jankralx/tt04-fm-transmitter/doc/board_photos/bot.jpg

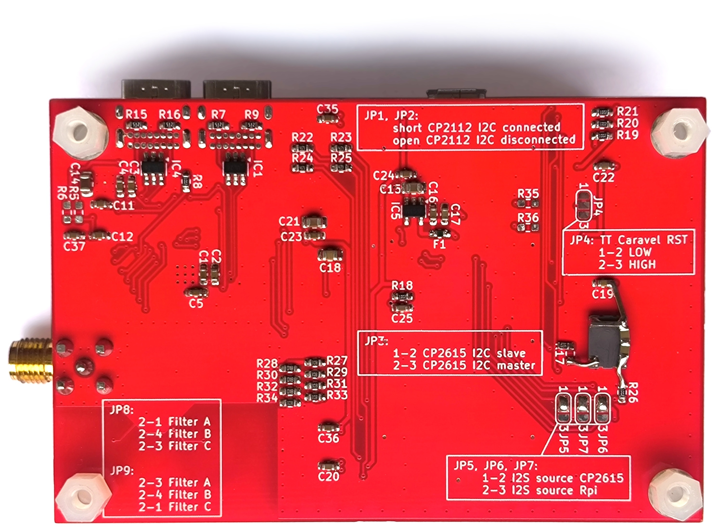
doc/board_photos/bot.jpg
