jankralx/tt04-fm-transmitter/doc/SDR_music.png

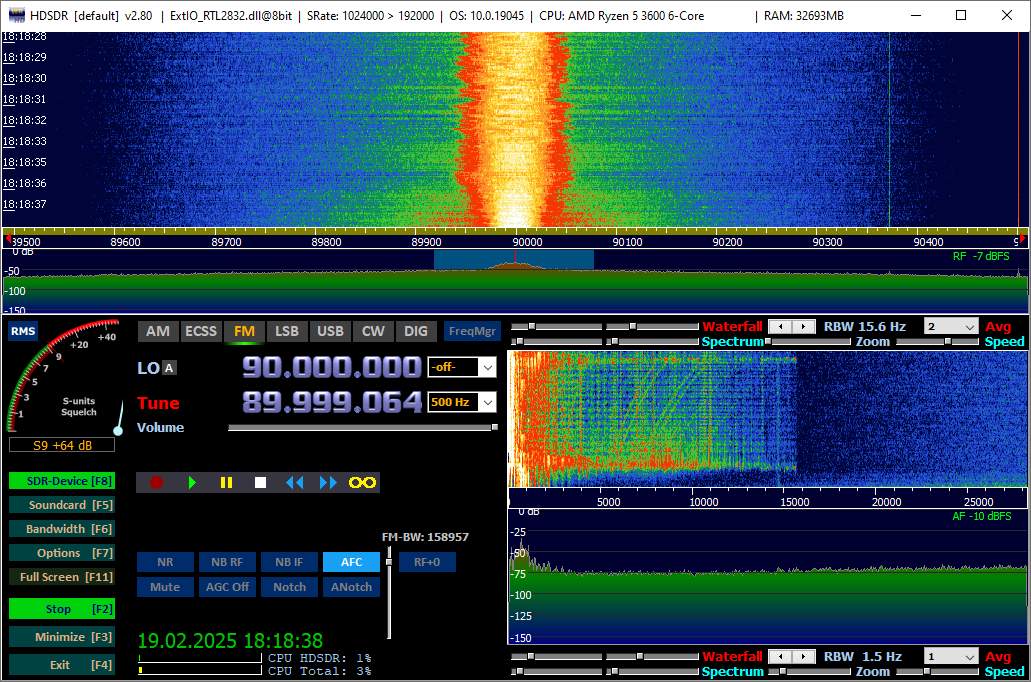
doc/SDR_music.png
