jankralx/tt04-fm-transmitter/doc/PDFs/diagram.pdf

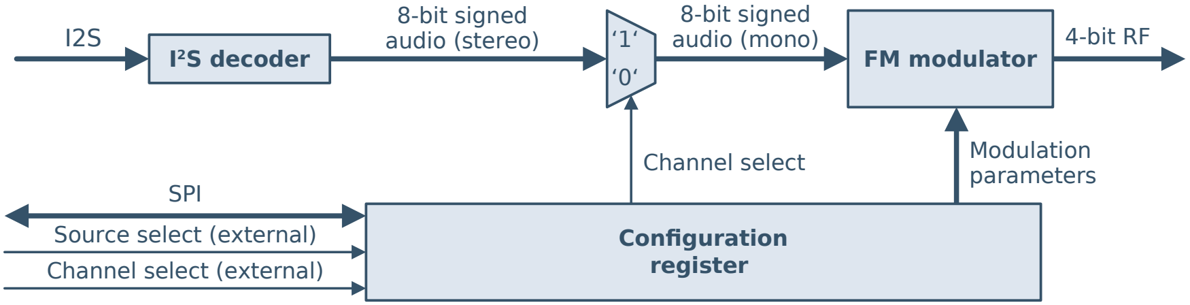
[picture p3: figure]
FM modulator; 4-bit RF; 8-bit signed audio (mono); 8-bit signed audio (stereo); SPI; 2S decoder; Channel select; Modulation; parameters; Configuration register; Source select (external); Channel select (external)
