jankralx/tt04-fm-transmitter/doc/board_photos/top.jpg

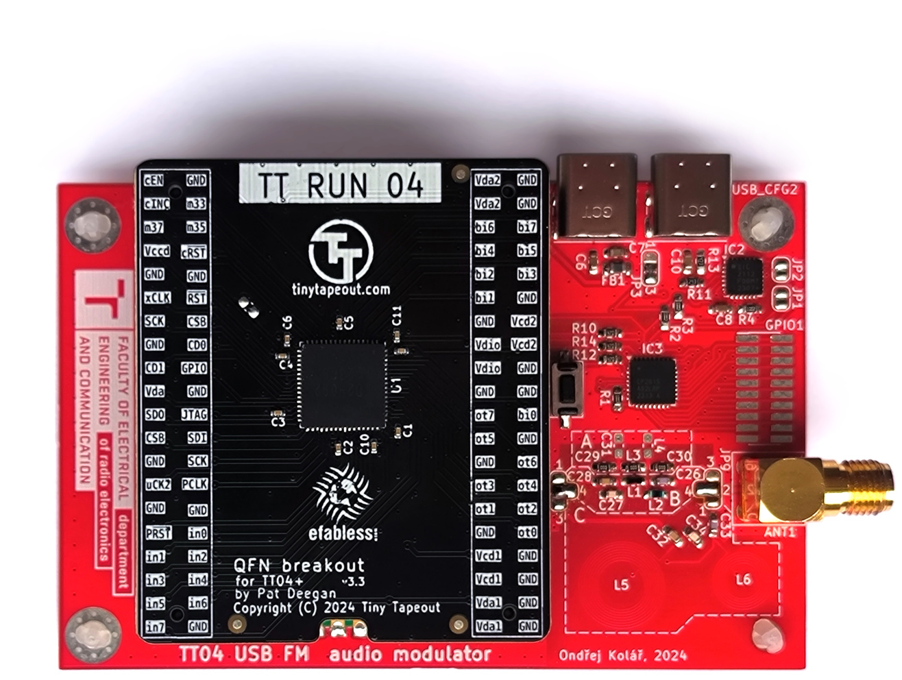
doc/board_photos/top.jpg
