jankralx/tt04-fm-transmitter/doc/figureApproximation.png

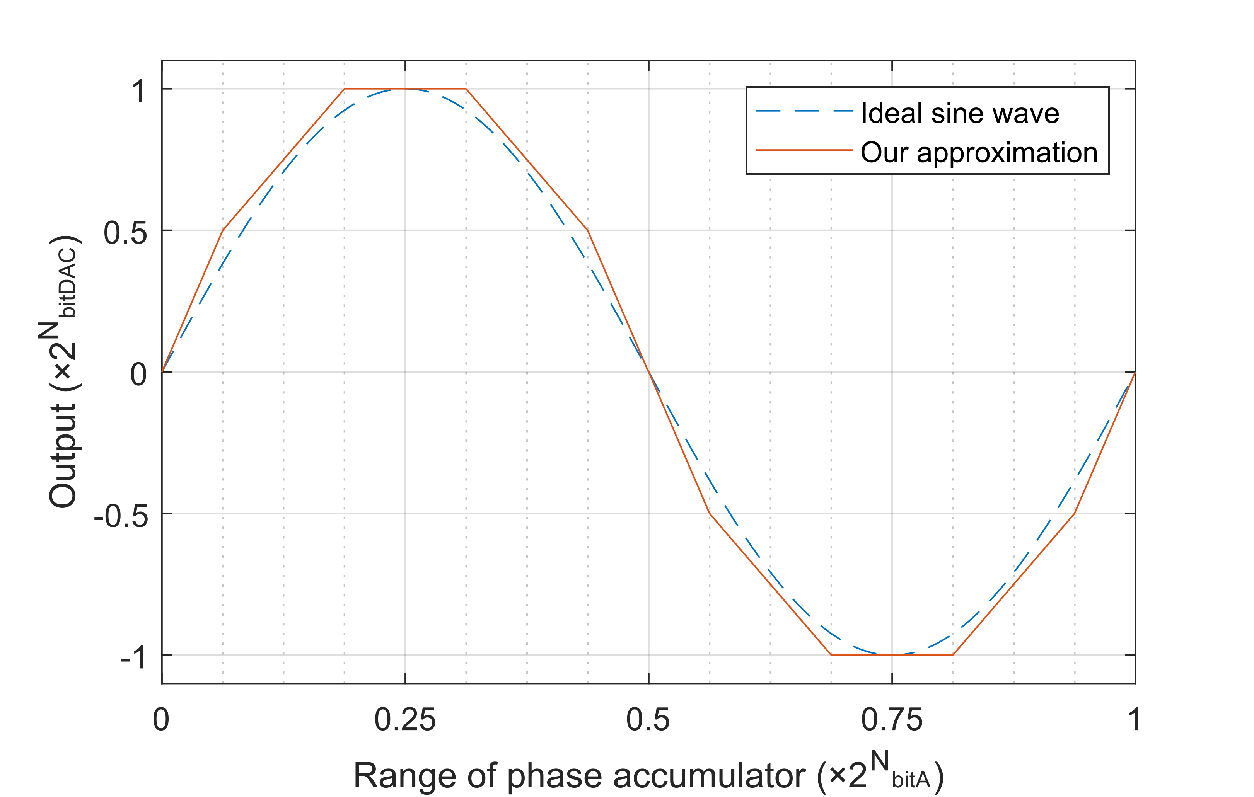
doc/figureApproximation.png
