jankralx/tt04-fm-transmitter/doc/measurements/spectra/10MHzSpan10kNemodul.png

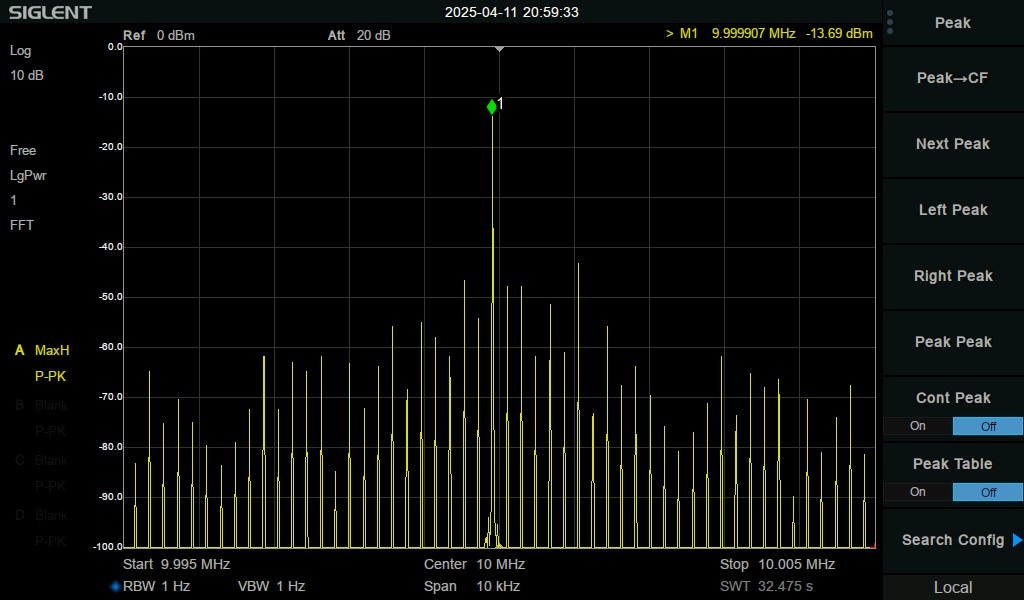
doc/measurements/spectra/10MHzSpan10kNemodul.png
