jankralx/tt04-fm-transmitter/doc/measurements/spectra/10MHzSpan100kNemodul.png

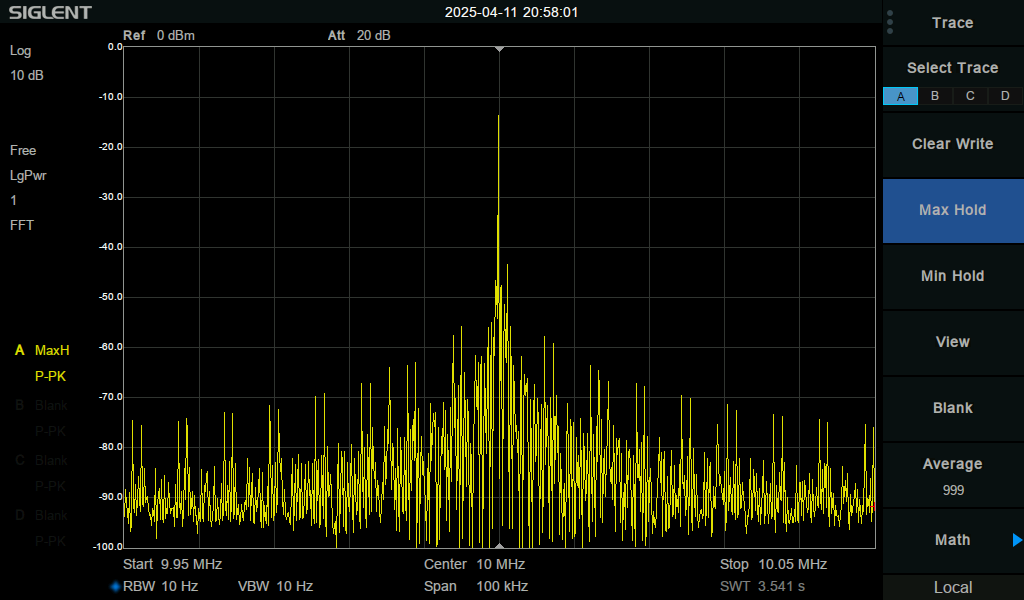
doc/measurements/spectra/10MHzSpan100kNemodul.png
