jankralx/tt04-fm-transmitter/doc/measurements/spectra/10MHzSpan200kModul1kHz.png

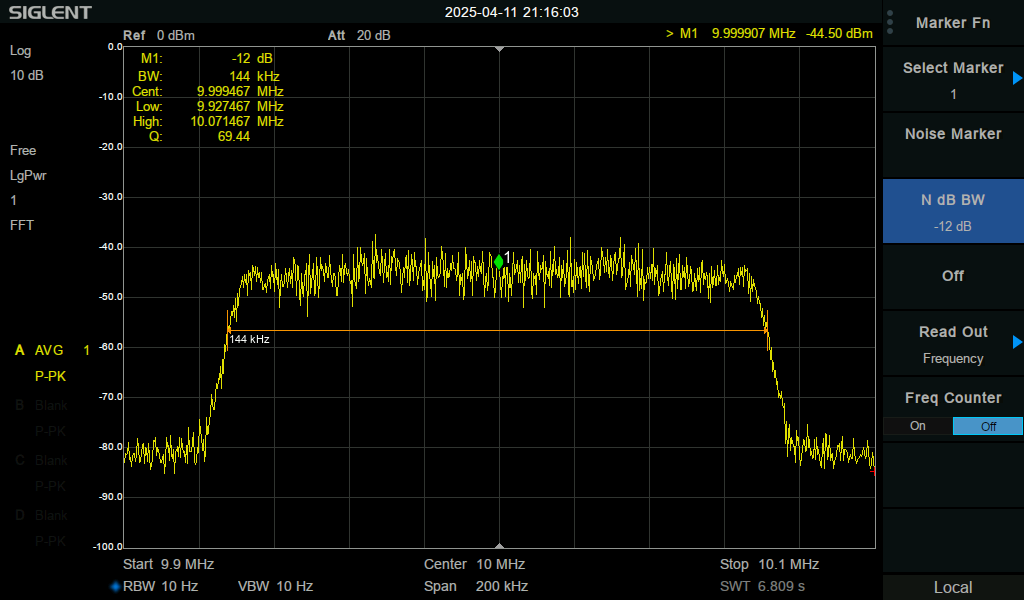
doc/measurements/spectra/10MHzSpan200kModul1kHz.png
