jankralx/tt04-fm-transmitter/doc/measurements/spectra/10MHzSpan200kNemodul.png

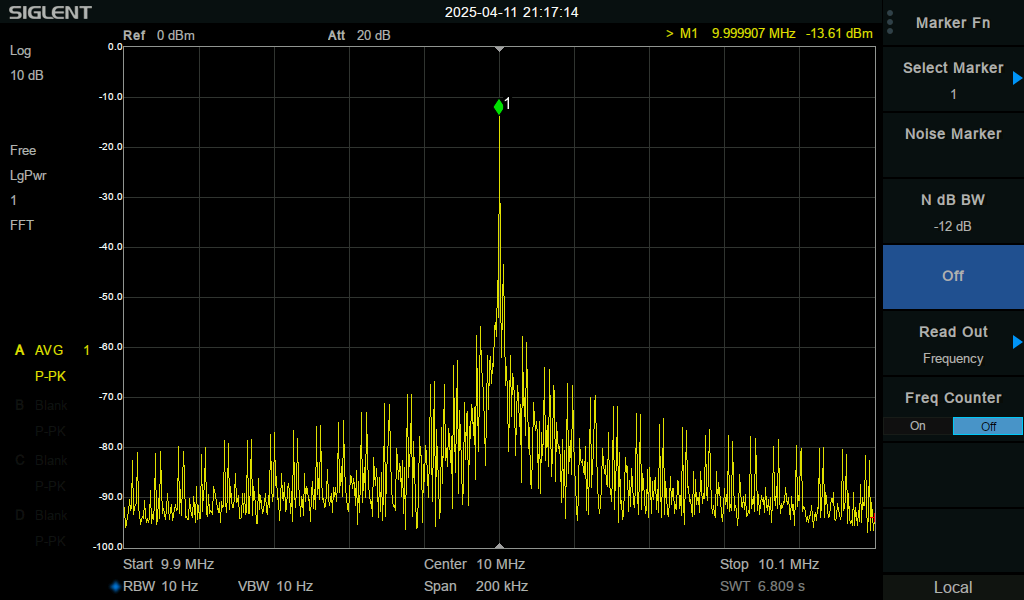
doc/measurements/spectra/10MHzSpan200kNemodul.png
