jankralx/tt04-fm-transmitter/doc/measurements/spectra/spectSiroke20dBattenuatorSinus10MHz.png

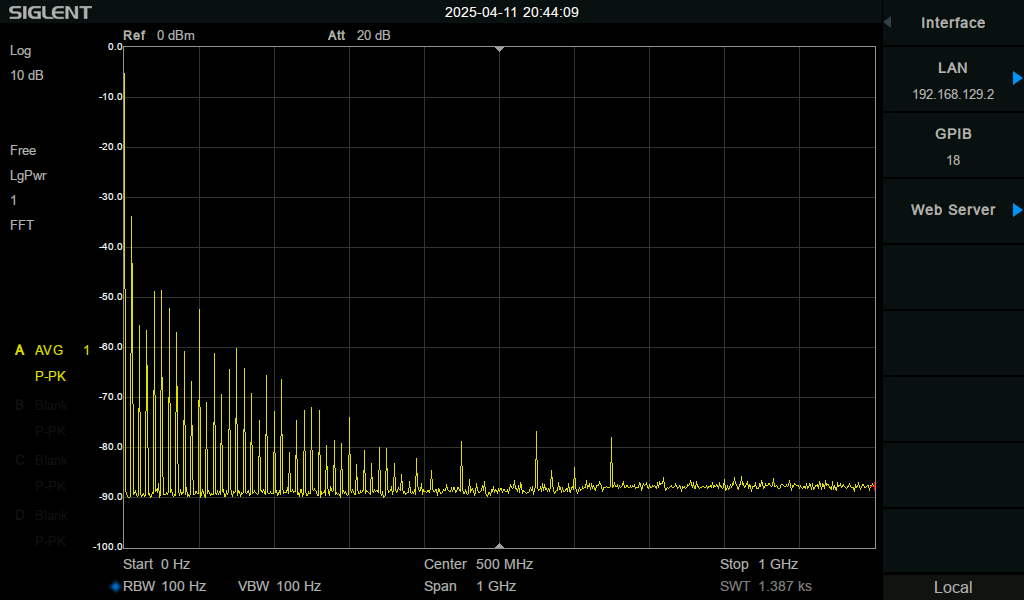
doc/measurements/spectra/spectSiroke20dBattenuatorSinus10MHz.png
