jankralx/tt04-fm-transmitter/doc/measurements/spectra/spectSirokeSinus10MHz.png

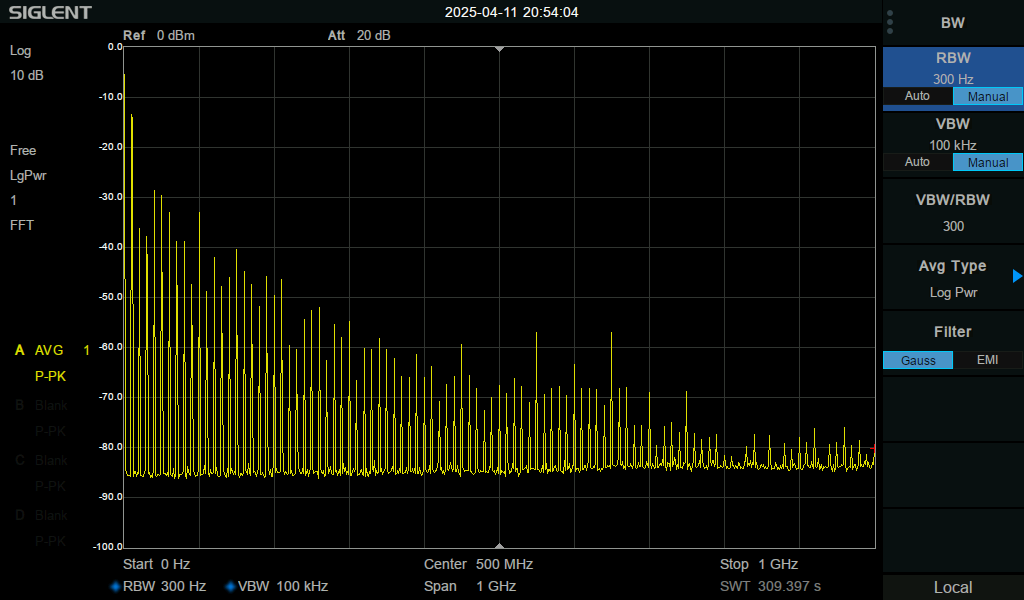
doc/measurements/spectra/spectSirokeSinus10MHz.png
