jankralx/tt04-fm-transmitter/doc/schematicDAC.png

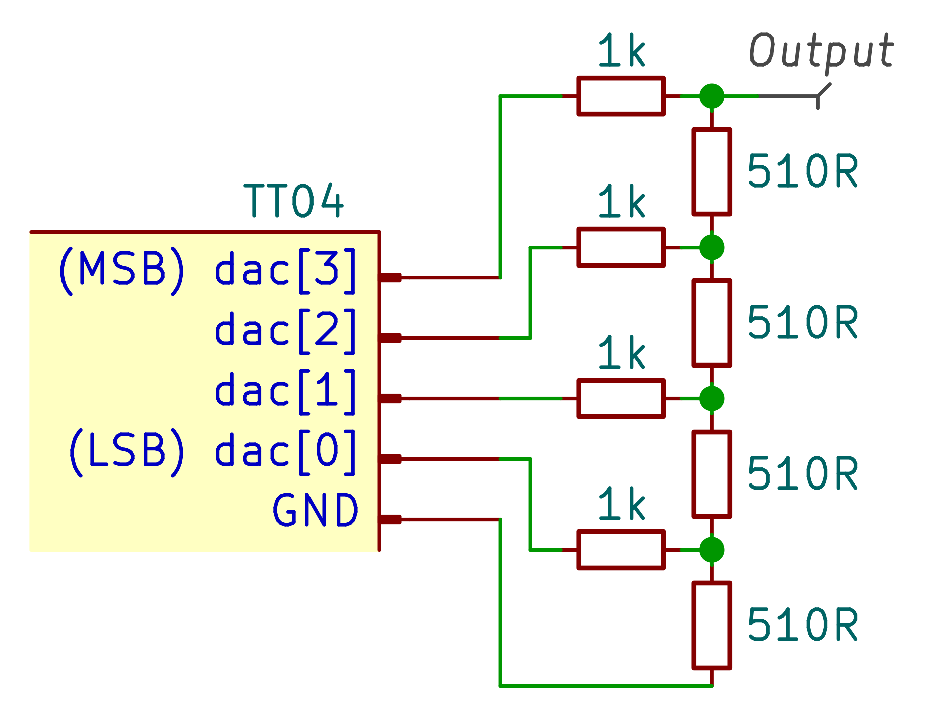
doc/schematicDAC.png
