jankralx/tt04-fm-transmitter/doc/SDR_1k-3k.png

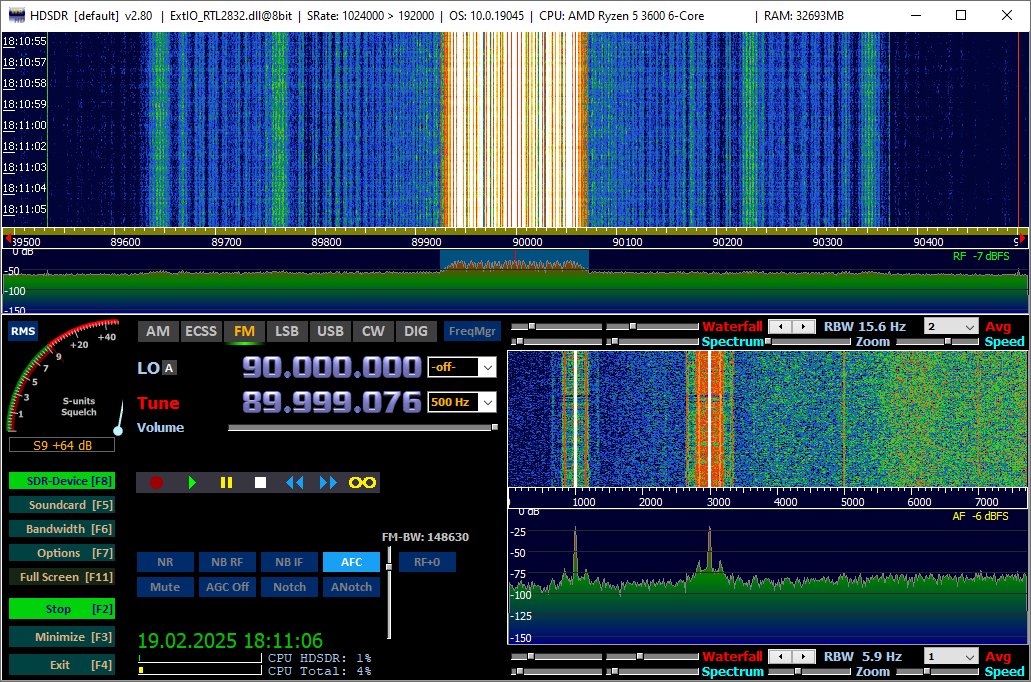
doc/SDR_1k-3k.png
