jankralx/tt04-fm-transmitter/doc/measurements/volt_vs_freq.ods

f [Hz] | VacRMS (FullScreen) [V] | VacRMS (Ncycles) [V]
9917 | 1,0971 | 1,0932
20026 | 1,0906 | 1,0912
49970 | 1,0898 | 1,0910
102300 | 1,0873 | 1,0933
200080 | 1,0915 | 1,0916
500100 | 1,0896 | 1,0897
1000500 | 1,0894 | 1,0886
2004000 | 1,0719 | 1,0718
3040000 | 1,0381 | 1,0368
4040000 | 0,9916 | 0,9932
5000000 | 0,9454 | 0,9453
5970000 | 0,8878 | 0,8890
7020000 | 0,8316 | 0,8315
8000000 | 0,7770 | 0,7769
10000000 | 0,6814 | 0,6817
