jankralx/tt04-fm-transmitter/USB_soundcard_board/filters_measurement/FILTER-DISCRETEINDUCTOR-S11.CSV

# Channel 1
# Trace 2
Frequency | Formatted Data | Formatted Data
+1.00000000000E+007 | -8.05534095848E-002 | +0.00000000000E+000
+1.00544726520E+007 | -8.08305097770E-002 | +0.00000000000E+000
+1.01089453039E+007 | -8.00701394577E-002 | +0.00000000000E+000
+1.01634179559E+007 | -8.10619074155E-002 | +0.00000000000E+000
+1.02178906078E+007 | -8.13308971631E-002 | +0.00000000000E+000
+1.02723632598E+007 | -8.13355740305E-002 | +0.00000000000E+000
+1.03268359117E+007 | -8.17213137161E-002 | +0.00000000000E+000
+1.03813085637E+007 | -8.17036681793E-002 | +0.00000000000E+000
+1.04357812156E+007 | -8.17499973012E-002 | +0.00000000000E+000
+1.04902538676E+007 | -8.15263690159E-002 | +0.00000000000E+000
+1.05447265195E+007 | -8.19725100287E-002 | +0.00000000000E+000
+1.05991991715E+007 | -8.20281509751E-002 | +0.00000000000E+000
+1.06536718234E+007 | -8.28763608103E-002 | +0.00000000000E+000
+1.07081444754E+007 | -8.34251513758E-002 | +0.00000000000E+000
+1.07626171274E+007 | -8.29005429490E-002 | +0.00000000000E+000
+1.08170897793E+007 | -8.33849082551E-002 | +0.00000000000E+000
+1.08715624313E+007 | -8.32252429333E-002 | +0.00000000000E+000
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
