jankralx/tt04-fm-transmitter/USB_soundcard_board/filters_measurement/FILTER-DISCRETEINDUCTOR-S21.CSV

# Channel 1
# Trace 1
Frequency | Formatted Data | Formatted Data
+1.00000000000E+007 | -4.32621229993E+001 | +0.00000000000E+000
+1.00544726520E+007 | -4.31568793695E+001 | +0.00000000000E+000
+1.01089453039E+007 | -4.30732940188E+001 | +0.00000000000E+000
+1.01634179559E+007 | -4.29863594990E+001 | +0.00000000000E+000
+1.02178906078E+007 | -4.28937749607E+001 | +0.00000000000E+000
+1.02723632598E+007 | -4.27994945822E+001 | +0.00000000000E+000
+1.03268359117E+007 | -4.27136273738E+001 | +0.00000000000E+000
+1.03813085637E+007 | -4.26300662892E+001 | +0.00000000000E+000
+1.04357812156E+007 | -4.25306540702E+001 | +0.00000000000E+000
+1.04902538676E+007 | -4.24387588132E+001 | +0.00000000000E+000
+1.05447265195E+007 | -4.23622155840E+001 | +0.00000000000E+000
+1.05991991715E+007 | -4.22624500128E+001 | +0.00000000000E+000
+1.06536718234E+007 | -4.21823019024E+001 | +0.00000000000E+000
+1.07081444754E+007 | -4.20939110200E+001 | +0.00000000000E+000
+1.07626171274E+007 | -4.20093204814E+001 | +0.00000000000E+000
+1.08170897793E+007 | -4.19189539698E+001 | +0.00000000000E+000
+1.08715624313E+007 | -4.18293240268E+001 | +0.00000000000E+000
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
