jankralx/tt04-fm-transmitter/USB_soundcard_board/filters_measurement/FILTER-PCBINDUCTOR-S11.CSV

# Channel 1
# Trace 2
Frequency | Formatted Data | Formatted Data
+1.00000000000E+007 | -1.48093832265E-001 | +0.00000000000E+000
+1.00544726520E+007 | -1.48414259285E-001 | +0.00000000000E+000
+1.01089453039E+007 | -1.48471097016E-001 | +0.00000000000E+000
+1.01634179559E+007 | -1.48457967387E-001 | +0.00000000000E+000
+1.02178906078E+007 | -1.48634034647E-001 | +0.00000000000E+000
+1.02723632598E+007 | -1.48665137640E-001 | +0.00000000000E+000
+1.03268359117E+007 | -1.48620974976E-001 | +0.00000000000E+000
+1.03813085637E+007 | -1.48830648549E-001 | +0.00000000000E+000
+1.04357812156E+007 | -1.48817402770E-001 | +0.00000000000E+000
+1.04902538676E+007 | -1.48938848628E-001 | +0.00000000000E+000
+1.05447265195E+007 | -1.49074061047E-001 | +0.00000000000E+000
+1.05991991715E+007 | -1.49262625980E-001 | +0.00000000000E+000
+1.06536718234E+007 | -1.49151259411E-001 | +0.00000000000E+000
+1.07081444754E+007 | -1.49352533357E-001 | +0.00000000000E+000
+1.07626171274E+007 | -1.49276833374E-001 | +0.00000000000E+000
+1.08170897793E+007 | -1.49322089334E-001 | +0.00000000000E+000
+1.08715624313E+007 | -1.49599038119E-001 | +0.00000000000E+000
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
