jankralx/tt04-fm-transmitter/USB_soundcard_board/filters_measurement/FILTER-PCBINDUCTOR-S21.CSV

# Channel 1
# Trace 1
Frequency | Formatted Data | Formatted Data
+1.00000000000E+007 | -6.04611075189E+001 | +0.00000000000E+000
+1.00544726520E+007 | -6.04056657832E+001 | +0.00000000000E+000
+1.01089453039E+007 | -6.03976873346E+001 | +0.00000000000E+000
+1.01634179559E+007 | -6.03089486575E+001 | +0.00000000000E+000
+1.02178906078E+007 | -6.02624120627E+001 | +0.00000000000E+000
+1.02723632598E+007 | -6.01904972721E+001 | +0.00000000000E+000
+1.03268359117E+007 | -6.01187718350E+001 | +0.00000000000E+000
+1.03813085637E+007 | -6.01026006687E+001 | +0.00000000000E+000
+1.04357812156E+007 | -6.00773782252E+001 | +0.00000000000E+000
+1.04902538676E+007 | -6.00073019066E+001 | +0.00000000000E+000
+1.05447265195E+007 | -5.99775336774E+001 | +0.00000000000E+000
+1.05991991715E+007 | -5.99033918301E+001 | +0.00000000000E+000
+1.06536718234E+007 | -5.98648918746E+001 | +0.00000000000E+000
+1.07081444754E+007 | -5.98028926043E+001 | +0.00000000000E+000
+1.07626171274E+007 | -5.97787722779E+001 | +0.00000000000E+000
+1.08170897793E+007 | -5.97636034247E+001 | +0.00000000000E+000
+1.08715624313E+007 | -5.96956193413E+001 | +0.00000000000E+000
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
