jankralx/tt04-fm-transmitter/doc/measurements/oscillograms/100khzMod10khz.csv

x-axis | 2
second | Volt
-100.000E-06 | +1.625000000E+00
-99.900E-06 | +1.966708539E+00
-99.800E-06 | +2.047110548E+00
-99.700E-06 | +2.383076087E+00
-99.600E-06 | +2.449120594E+00
-99.500E-06 | +2.586952610E+00
-99.400E-06 | +2.658740118E+00
-99.300E-06 | +2.790829133E+00
-99.200E-06 | +2.868359642E+00
-99.100E-06 | +2.871231142E+00
-99.000E-06 | +3.072236165E+00
-98.900E-06 | +3.077979166E+00
-98.800E-06 | +3.075107666E+00
-98.700E-06 | +3.092336668E+00
-98.600E-06 | +3.092336668E+00
-98.500E-06 | +3.092336668E+00
-98.400E-06 | +3.092336668E+00
-98.300E-06 | +3.098079668E+00
-98.200E-06 | +3.086593667E+00
-98.100E-06 | +3.095208168E+00
-98.000E-06 | +3.092336668E+00
-97.900E-06 | +3.092336668E+00
-97.800E-06 | +2.882717144E+00
-97.700E-06 | +2.871231142E+00
-97.600E-06 | +2.675969120E+00
-97.500E-06 | +2.675969120E+00
-97.400E-06 | +2.486450098E+00
-97.300E-06 | +2.449120594E+00
-97.200E-06 | +2.047110548E+00
-97.100E-06 | +2.038496047E+00
-97.000E-06 | +1.759960515E+00
-96.900E-06 | +1.645100502E+00
-96.800E-06 | +1.645100502E+00
-96.700E-06 | +1.627871500E+00
-96.600E-06 | +1.590541996E+00
-96.500E-06 | +1.222989954E+00
-96.400E-06 | +1.234475955E+00
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
