jankralx/tt04-fm-transmitter/doc/measurements/oscillograms/10khz.csv

x-axis | 2
second | Volt
-100.000E-06 | +1.604899498E+00
-99.900E-06 | +1.596284997E+00
-99.800E-06 | +1.584798995E+00
-99.700E-06 | +1.596284997E+00
-99.600E-06 | +1.604899498E+00
-99.500E-06 | +1.604899498E+00
-99.400E-06 | +1.596284997E+00
-99.300E-06 | +1.584798995E+00
-99.200E-06 | +1.602027997E+00
-99.100E-06 | +1.604899498E+00
-99.000E-06 | +1.590541996E+00
-98.900E-06 | +1.590541996E+00
-98.800E-06 | +1.602027997E+00
-98.700E-06 | +1.604899498E+00
-98.600E-06 | +1.584798995E+00
-98.500E-06 | +1.607770998E+00
-98.400E-06 | +1.587670496E+00
-98.300E-06 | +1.604899498E+00
-98.200E-06 | +1.599156497E+00
-98.100E-06 | +1.625000000E+00
-98.000E-06 | +1.590541996E+00
-97.900E-06 | +1.564698493E+00
-97.800E-06 | +1.596284997E+00
-97.700E-06 | +1.587670496E+00
-97.600E-06 | +1.590541996E+00
-97.500E-06 | +1.599156497E+00
-97.400E-06 | +1.604899498E+00
-97.300E-06 | +1.581927495E+00
-97.200E-06 | +1.604899498E+00
-97.100E-06 | +1.581927495E+00
-97.000E-06 | +1.604899498E+00
-96.900E-06 | +1.619256999E+00
-96.800E-06 | +1.610642498E+00
-96.700E-06 | +1.607770998E+00
-96.600E-06 | +1.593413496E+00
-96.500E-06 | +1.604899498E+00
-96.400E-06 | +1.596284997E+00
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
