jankralx/tt04-fm-transmitter/doc/measurements/oscillograms/1mhz.png

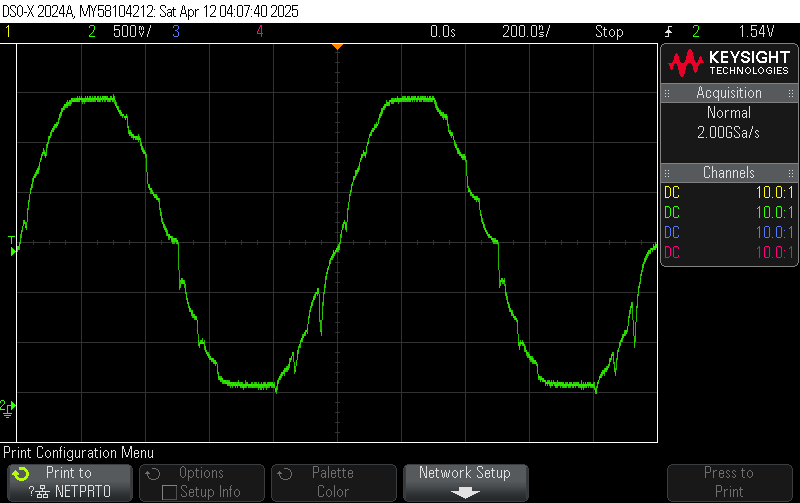
doc/measurements/oscillograms/1mhz.png
