jankralx/tt04-fm-transmitter/doc/measurements/oscillograms/10khz.png

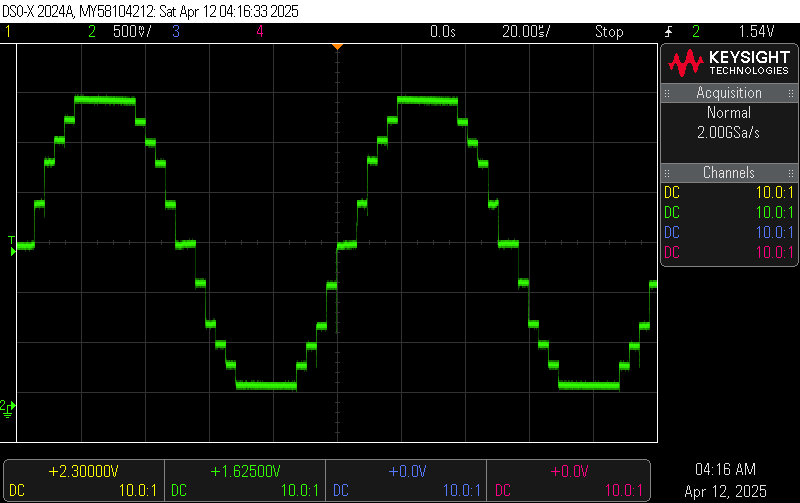
doc/measurements/oscillograms/10khz.png
