jankralx/tt04-fm-transmitter/doc/measurements/oscillograms/10mhz.png

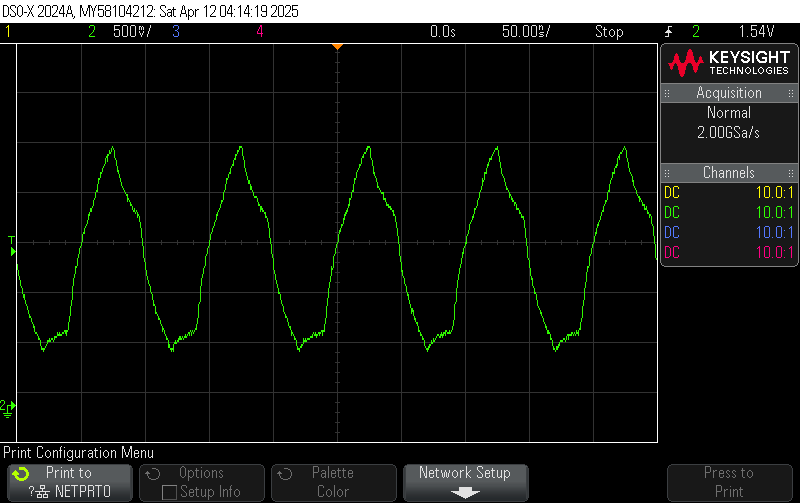
doc/measurements/oscillograms/10mhz.png
