jankralx/tt04-fm-transmitter/doc/measurements/oscillograms/100khzMod10khz.png

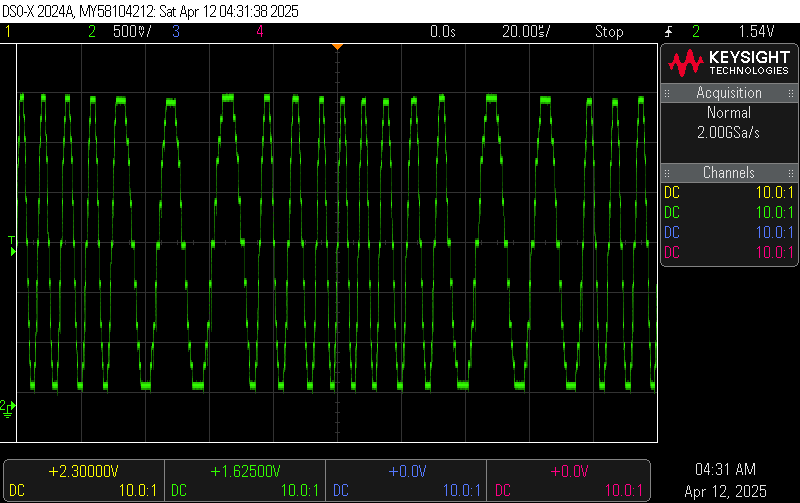
doc/measurements/oscillograms/100khzMod10khz.png
