jankralx/tt04-fm-transmitter/USB_soundcard_board/filters_measurement/FILTER-DISCRETEINDUCTOR.PNG

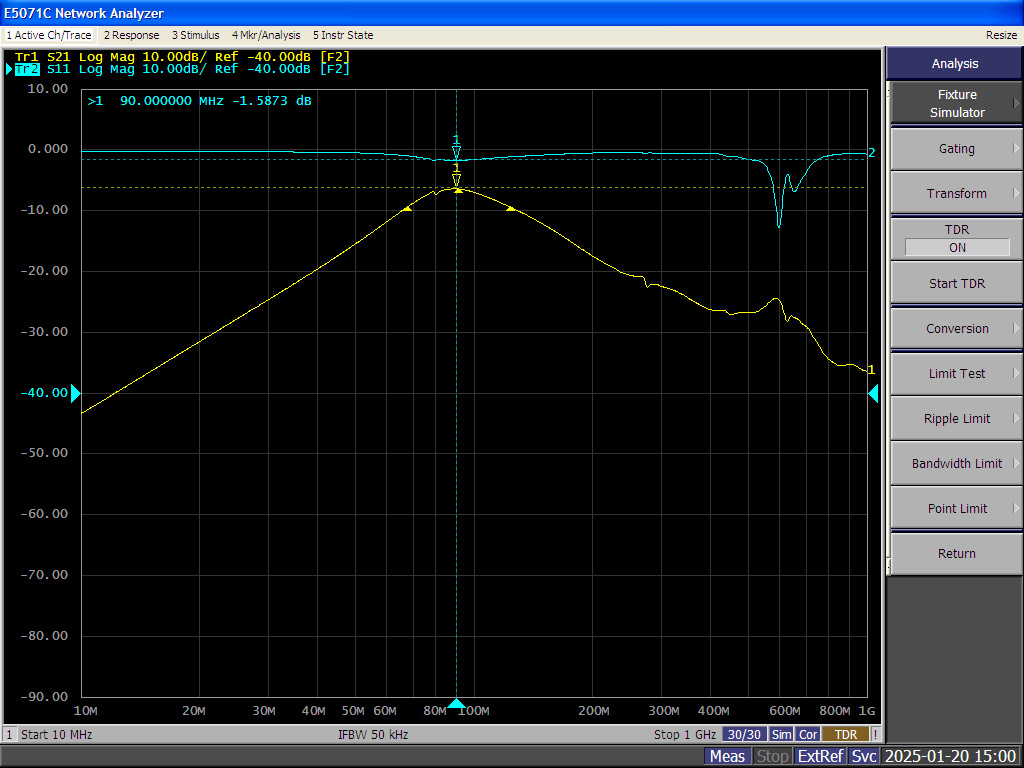
USB_soundcard_board/filters_measurement/FILTER-DISCRETEINDUCTOR.PNG
