jankralx/tt04-fm-transmitter/USB_soundcard_board/filters_measurement/FILTER-PCBINDUCTOR2.PNG

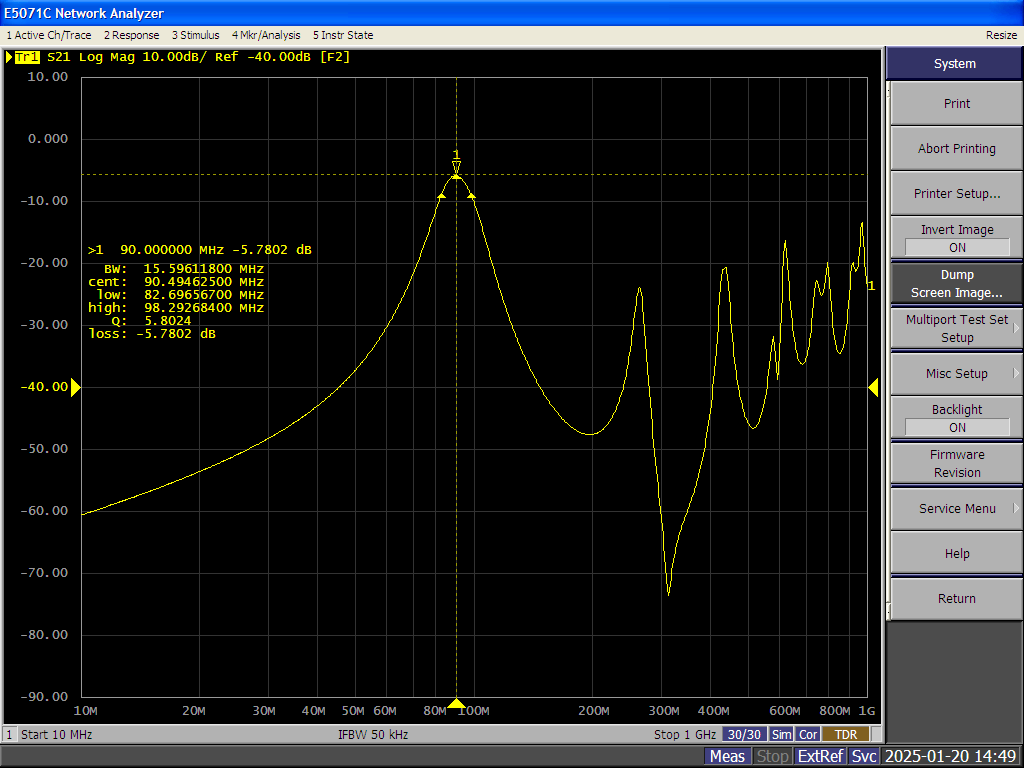
USB_soundcard_board/filters_measurement/FILTER-PCBINDUCTOR2.PNG
