jankralx/tt04-fm-transmitter/doc/PDFs/schematicDAC.pdf

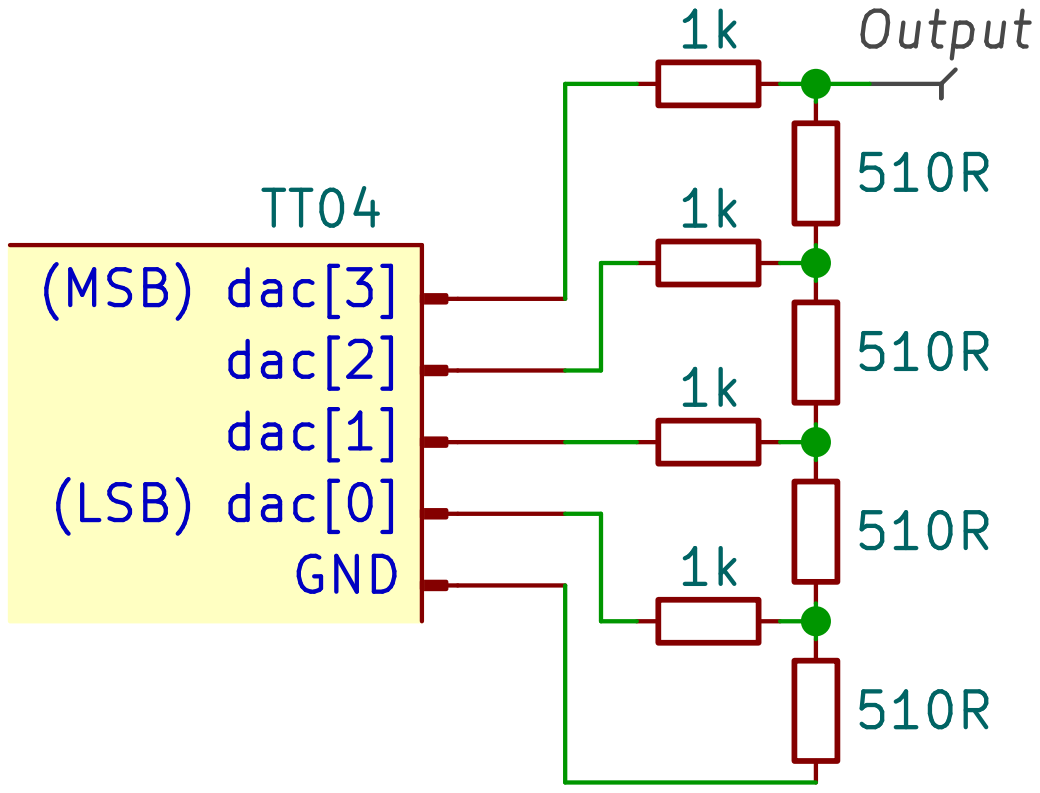
[picture p21: page 1]
