jankralx/tt04-fm-transmitter/doc/PDFs/figureApproximation.pdf

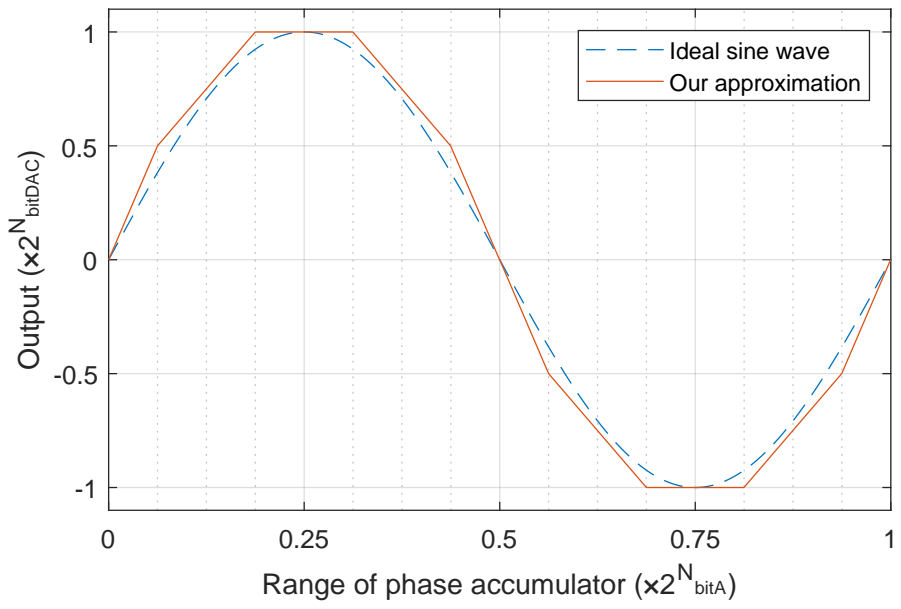
[picture p22: page 1]
bitA); Output (×2; bitDAC)

Ideal sine wave
Our approximation

Range of phase accumulator (×2N
