jankralx/tt04-fm-transmitter/USB_soundcard_board/USB_soundcard_board.kicad_pcb

## KiCad design USB_soundcard_board/USB_soundcard_board.kicad_pcb (2024-09-18)

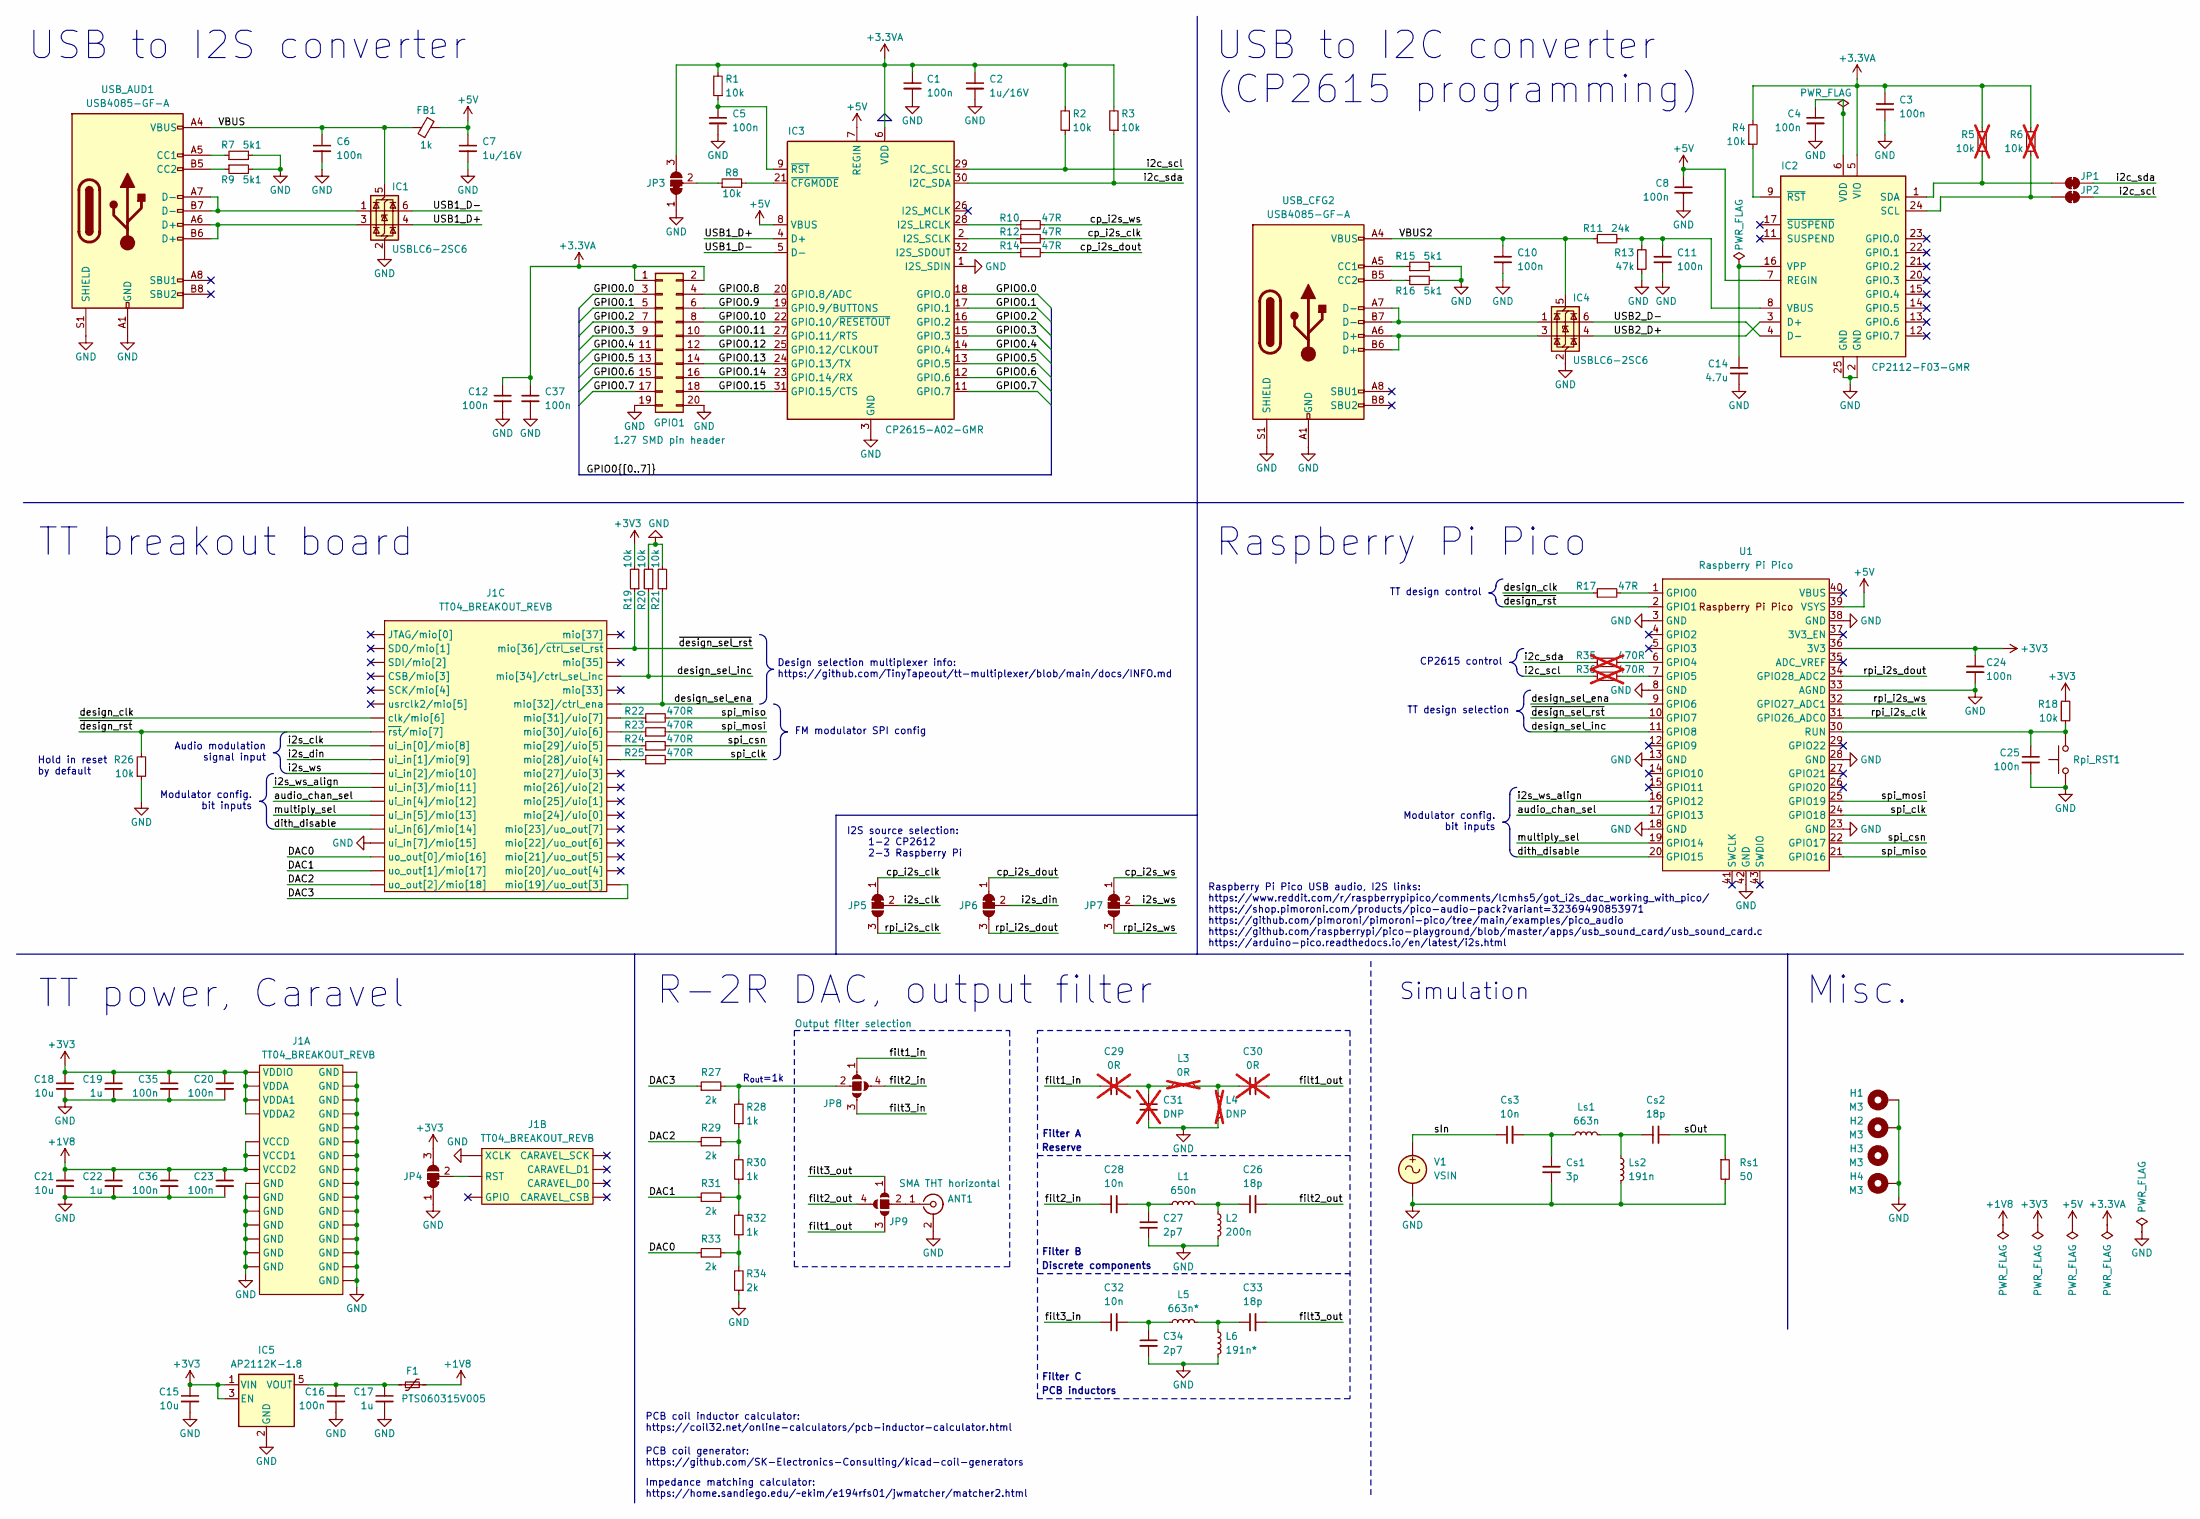
[picture p23: schematic USB_soundcard_board.kicad_sch]

Parts:
ANT1: SMA THT horizontal; SMA_Amphenol_132203-12_Horizontal
C1, C3, C4, C5, C6, C8, C10, C11, C12, C16, C20, C23, C24, C25, C35, C36, C37: 100n; C_0603_1608Metric_Pad1.08x0.95mm_HandSolder
C2, C7: 1u/16V; C_0603_1608Metric_Pad1.08x0.95mm_HandSolder
C14: 4.7u; C_0805_2012Metric_Pad1.18x1.45mm_HandSolder
C15, C18, C21: 10u; C_0805_2012Metric_Pad1.18x1.45mm_HandSolder
C17, C19, C22: 1u; C_0603_1608Metric_Pad1.08x0.95mm_HandSolder
C26, C33: 18p; C_0603_1608Metric_Pad1.08x0.95mm_HandSolder
C27, C34: 2p7; C_0603_1608Metric_Pad1.08x0.95mm_HandSolder
C28, C32: 10n; C_0603_1608Metric_Pad1.08x0.95mm_HandSolder
C29, C30: 0R; C_0603_1608Metric_Pad1.08x0.95mm_HandSolder; not fitted
C31: DNP; C_0603_1608Metric_Pad1.08x0.95mm_HandSolder; not fitted
Cs1: 3p
Cs2: 18p
Cs3: 10n
F1: PTS060315V005; Fuse_0603_1608Metric_Pad1.05x0.95mm_HandSolder
FB1: 1k; L_0805_2012Metric_Pad1.15x1.40mm_HandSolder
GPIO1: 1.27 SMD pin header; PinHeader_2x10_P1.27mm_Vertical_SMD
H1, H2, H4: M3; MountingHole_3.2mm_M3_Pad_Via
H3: M3; MountingHole_3.2mm_M3
IC1, IC4: USBLC6-2SC6; SOT-23-6_Handsoldering
IC2: CP2112-F03-GMR; QFN-24-1EP_4x4mm_P0.5mm_EP2.6x2.6mm_ThermalVias
IC3: CP2615-A02-GMR; QFN-32-1EP_5x5mm_P0.5mm_EP3.3x3.3mm_ThermalVias
IC5: AP2112K-1.8; SOT-23-5
J1: TT04_BREAKOUT_REVB; TT04_BREAKOUT_SMB
JP1, JP2: SolderJumper_2_Bridged; SolderJumper-2_P1.3mm_Bridged_RoundedPad1.0x1.5mm
JP3, JP4, JP5, JP6, JP7: SolderJumper_3_Bridged12; SolderJumper-3_P1.3mm_Bridged12_RoundedPad1.0x1.5mm_NumberL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
JP8, JP9: Output filter selection; SolderJumper-4_P1.3mm_Open_RoundedPad1.0x1.5mm_NumberLabels
L1: 650n; L_0603_1608Metric_Pad1.05x0.95mm_HandSolder
L2: 200n; L_0603_1608Metric_Pad1.05x0.95mm_HandSolder
L3: 0R; L_0603_1608Metric_Pad1.05x0.95mm_HandSolder; not fitted
L4: DNP; L_0603_1608Metric_Pad1.05x0.95mm_HandSolder; not fitted
L5: 663n*; Inductor_663nH
L6: 191n*; Inductor_191nH
Ls1: 663n
Ls2: 191n
R1, R2, R3, R4, R8, R18, R19, R20, R21, R26: 10k; R_0603_1608Metric_Pad0.98x0.95mm_HandSolder
R5, R6: 10k; R_0603_1608Metric_Pad0.98x0.95mm_HandSolder; not fitted
R7, R9, R15, R16: 5k1; R_0603_1608Metric_Pad0.98x0.95mm_HandSolder
R10, R12, R14, R17: 47R; R_0603_1608Metric_Pad0.98x0.95mm_HandSolder
R11: 24k; R_0603_1608Metric_Pad0.98x0.95mm_HandSolder
R13: 47k; R_0603_1608Metric_Pad0.98x0.95mm_HandSolder
R22, R23, R24, R25: 470R; R_0603_1608Metric_Pad0.98x0.95mm_HandSolder
R27, R29, R31, R33, R34: 2k; R_0603_1608Metric_Pad0.98x0.95mm_HandSolder
R28, R30, R32: 1k; R_0603_1608Metric_Pad0.98x0.95mm_HandSolder
R35, R36: 470R; R_0603_1608Metric_Pad0.98x0.95mm_HandSolder; not fitted
Rpi_RST1: Raspberry Pi reset; SW_Tactile_SPST_NO_Straight_CK_PTS636Sx25SMTRLFS
Rs1: 50
U1: Raspberry Pi Pico; RPi_Pico_SMD_TH
USB_AUD1: USB4085-GF-A; USB_C_Receptacle_GCT_USB4085
USB_CFG2: USB4085-GF-A; USB_C_Receptacle_GCT_USB4085
V1: VSIN

Connections:
+1V8: C21.1, C22.1, C23.1, C36.1, F1.2, J1.A7 (VCCD), J1.B14 (VCCD2), J1.B16 (VCCD2), J1.B33 (VCCD1), J1.B35 (VCCD1)
+3.3VA: C1.1, C2.1, C3.1, C12.1, C37.1, GPIO1.1, GPIO1.2, IC2.5 (VIO), IC3.6 (VDD), JP3.3 (B), R1.2, R2.2, R3.2, R4.2, R5.2, R6.2
+3V3: C15.1, C18.1, C19.1, C20.1, C24.1, C35.1, IC5.1 (VIN), IC5.3 (EN), J1.A19 (VDDA), J1.B1 (VDDA2), J1.B3 (VDDA2), J1.B15 (VDDIO), J1.B17 (VDDIO), J1.B37 (VDDA1), J1.B39 (VDDA1), JP4.3 (B), R18.2, R19.2, U1.36 (3V3)
+5V: C7.1, C8.1, FB1.2, IC2.7 (REGIN), IC3.7 (REGIN), IC3.8 (VBUS), U1.39 (VSYS)
/DAC0: J1.B32 (uo_out[0]/mio[16]), R33.1
/DAC1: J1.B29 (uo_out[1]/mio[17]), R31.1
/DAC2: J1.B30 (uo_out[2]/mio[18]), R29.1
/DAC3: J1.B27 (mio[19]/uo_out[3]), R27.1
/GPIO0.0: GPIO1.3, IC3.18 (GPIO.0)
/GPIO0.1: GPIO1.5, IC3.17 (GPIO.1)
/GPIO0.2: GPIO1.7, IC3.16 (GPIO.2)
/GPIO0.3: GPIO1.9, IC3.15 (GPIO.3)
/GPIO0.4: GPIO1.11, IC3.14 (GPIO.4)
/GPIO0.5: GPIO1.13, IC3.13 (GPIO.5)
/GPIO0.6: GPIO1.15, IC3.12 (GPIO.6)
/GPIO0.7: GPIO1.17, IC3.11 (GPIO.7)
/GPIO0.8: GPIO1.4, IC3.20 (GPIO.8/ADC)
/GPIO0.9: GPIO1.6, IC3.19 (GPIO.9/BUTTONS)
/GPIO0.10: GPIO1.8, IC3.22 (GPIO.10/~RESETOUT)
/GPIO0.11: GPIO1.10, IC3.27 (GPIO.11/RTS)
/GPIO0.12: GPIO1.12, IC3.25 (GPIO.12/CLKOUT)
/GPIO0.13: GPIO1.14, IC3.24 (GPIO.13/TX)
/GPIO0.14: GPIO1.16, IC3.23 (GPIO.14/RX)
/GPIO0.15: GPIO1.18, IC3.31 (GPIO.15/CTS)
/USB1_D+: IC1.4 (I/O2), IC3.4 (D+)
/USB1_D-: IC1.6 (I/O1), IC3.5 (D-)
/USB2_D+: IC2.3 (D+), IC4.4 (I/O2)
/USB2_D-: IC2.4 (D-), IC4.6 (I/O1)
/VBUS: C6.1, FB1.1, IC1.5 (VBUS), USB_AUD1.A4 (VBUS), USB_AUD1.A9 (VBUS), USB_AUD1.B4 (VBUS), USB_AUD1.B9 (VBUS)
/VBUS2: C10.1, IC4.5 (VBUS), R11.1, USB_CFG2.A4 (VBUS), USB_CFG2.A9 (VBUS), USB_CFG2.B4 (VBUS), USB_CFG2.B9 (VBUS)
/audio_chan_sel: J1.A36 (ui_in[4]/mio[12]), U1.17 (GPIO13)
/cp_i2s_clk: JP5.1 (A), R12.2
/cp_i2s_dout: JP6.1 (A), R14.2
/cp_i2s_ws: JP7.1 (A), R10.2
/design_clk: J1.A28 (clk/mio[6]), R17.1
/design_sel_ena: J1.A1 (mio[32]/ctrl_ena), R21.1, U1.9 (GPIO6)
/design_sel_inc: J1.A3 (mio[34]/ctrl_sel_inc), R20.1, U1.11 (GPIO8)
/dith_disable: J1.A38 (ui_in[6]/mio[14]), U1.20 (GPIO15)
/filt1_in: C29.1, JP8.1 (A)
/filt1_out: C30.2, JP9.3 (B)
/filt2_in: C28.1, JP8.4 (D)
/filt2_out: C26.2, JP9.4 (D)
/filt3_in: C32.1, JP8.3 (B)
/filt3_out: C33.2, JP9.1 (A)
/i2c_scl: IC3.29 (I2C_SCL), JP2.2 (B), R2.1, R36.1
/i2c_sda: IC3.30 (I2C_SDA), JP1.2 (B), R3.1, R35.1
/i2s_clk: J1.A32 (ui_in[0]/mio[8]), JP5.2 (C)
/i2s_din: J1.A33 (ui_in[1]/mio[9]), JP6.2 (C)
/i2s_ws: J1.A34 (ui_in[2]/mio[10]), JP7.2 (C)
/i2s_ws_align: J1.A35 (ui_in[3]/mio[11]), U1.16 (GPIO12)
/multiply_sel: J1.A37 (ui_in[5]/mio[13]), U1.19 (GPIO14)
/rpi_i2s_clk: JP5.3 (B), U1.31 (GPIO26_ADC0)
/rpi_i2s_dout: JP6.3 (B), U1.34 (GPIO28_ADC2)
/rpi_i2s_ws: JP7.3 (B), U1.32 (GPIO27_ADC1)
/spi_clk: R25.2, U1.24 (GPIO18)
/spi_csn: R24.2, U1.22 (GPIO17)
/spi_miso: R22.2, U1.21 (GPIO16)
/spi_mosi: R23.2, U1.25 (GPIO19)
/~design_rst: J1.A31 (~rst/mio[7]), R26.2, U1.2 (GPIO1)
/~design_sel_rst: J1.A8 (mio[36]/~ctrl_sel_rst), R19.1, U1.10 (GPIO7)
GND: ANT1.2 (Ext), C1.2, C2.2, C3.2, C4.2, C5.2, C6.2, C7.2, C8.2, C10.2, C11.2, C12.2, C14.2, C15.2, C16.2, C17.2, C18.2, C19.2, C20.2, C21.2, C22.2, C23.2, C24.2, C25.2, C27.2, C31.2, C34.2, C35.2, C36.2, C37.2, Cs1.2, GPIO1.19, GPIO1.20, H1.1, H2.1, H4.1, IC1.2 (GND), IC2.2 (GND), IC2.25 (GND), IC3.1 (I2S_SDIN), IC3.3 (GND), IC3.33 (GND), IC4.2 (GND), IC5.2 (GND), J1.A2 (GND), J1.A9 (GND), J1.A10 (GND), J1.A11 (XCLK), J1.A15 (GND), J1.A20 (GND), J1.A25 (GND), J1.A29 (GND), J1.A30 (GND), J1.A39 (ui_in[7]/mio[15]), J1.A40 (GND), J1.B2 (GND), J1.B4 (GND), J1.B12 (GND), J1.B13 (GND), J1.B18 (GND), J1.B19 (GND), J1.B20 (GND), J1.B24 (GND), J1.B25 (GND), J1.B31 (GND), J1.B34 (GND), J1.B36 (GND), J1.B38 (GND), J1.B40 (GND), JP3.1 (A), JP4.1 (A), L2.2, L4.2, L6.2, Ls2.2, R7.2, R9.2, R13.1, R15.2, R16.2, R20.2, R21.2, R26.1, R34.1, Rpi_RST1.1, Rs1.2, U1.3 (GND), U1.8 (GND), U1.13 (GND), U1.18 (GND), U1.23 (GND), U1.28 (GND), U1.33 (AGND), U1.38 (GND), U1.42 (GND), USB_AUD1.A1 (GND), USB_AUD1.A12 (GND), USB_AUD1.B1 (GND), USB_AUD1.B12 (GND), USB_AUD1.S1 (SHIELD), USB_CFG2.A1 (GND), USB_CFG2.A12 (GND), USB_CFG2.B1 (GND), USB_CFG2.B12 (GND), USB_CFG2.S1 (SHIELD), V1.2
unnamed: ANT1.1 (In), JP9.2 (C)
unnamed: C26.1, L1.2, L2.1
unnamed: C27.1, C28.2, L1.1
unnamed: C29.2, C31.1, L3.1
unnamed: C30.1, L3.2, L4.1
unnamed: C32.2, C34.1, L5.1
unnamed: C33.1, L5.2, L6.1
unnamed: Cs1.1, Cs3.2, Ls1.1
unnamed: Cs2.1, Ls1.2, Ls2.1
unnamed: Cs2.2, Rs1.1
unnamed: Cs3.1, V1.1
unnamed: IC1.1 (I/O1), USB_AUD1.A7 (D-), USB_AUD1.B7 (D-)
unnamed: IC1.3 (I/O2), USB_AUD1.A6 (D+), USB_AUD1.B6 (D+)
unnamed: IC2.24 (SCL), JP2.1 (A), R6.1
unnamed: IC2.1 (SDA), JP1.1 (A), R5.1
unnamed: C11.1, IC2.8 (VBUS), R11.2, R13.2
unnamed: C4.1, IC2.6 (VDD)
unnamed: C14.1, IC2.16 (VPP)
unnamed: IC2.9 (~RST), R4.1
unnamed: IC3.28 (I2S_LRCLK), R10.1
unnamed: IC3.2 (I2S_SCLK), R12.1
unnamed: IC3.32 (I2S_SDOUT), R14.1
unnamed: IC3.21 (~CFGMODE), R8.2
unnamed: C5.1, IC3.9 (~RST), R1.1
unnamed: IC4.1 (I/O1), USB_CFG2.A7 (D-), USB_CFG2.B7 (D-)
unnamed: IC4.3 (I/O2), USB_CFG2.A6 (D+), USB_CFG2.B6 (D+)
unnamed: C16.1, C17.1, F1.1, IC5.5 (VOUT)
unnamed: J1.A12 (RST), JP4.2 (C)
unnamed: J1.B7 (mio[28]/uio[4]), R25.1
unnamed: J1.B8 (mio[29]/uio[5]), R24.1
unnamed: J1.B5 (mio[30]/uio[6]), R23.1
unnamed: J1.B6 (mio[31]/uio[7]), R22.1
unnamed: JP3.2 (C), R8.1
unnamed: JP8.2 (C), R27.2, R28.2
unnamed: R28.1, R29.2, R30.2
unnamed: R30.1, R31.2, R32.2
unnamed: R32.1, R33.2, R34.2
unnamed: R17.2, U1.1 (GPIO0)
unnamed: R35.2, U1.6 (GPIO4)
unnamed: R36.2, U1.7 (GPIO5)
unnamed: C25.1, R18.1, Rpi_RST1.2, U1.30 (RUN)
unnamed: R7.1, USB_AUD1.A5 (CC1)
unnamed: R9.1, USB_AUD1.B5 (CC2)
unnamed: R15.1, USB_CFG2.A5 (CC1)
unnamed: R16.1, USB_CFG2.B5 (CC2)

Notes on the sheet:
Modulator config. bit inputs
TT power, Caravel
I2S source selection: 1-2 CP2612 2-3 Raspberry Pi
Design selection multiplexer info: https://github.com/TinyTapeout/tt-multiplexer/blob/main/docs/INFO.md
USB to I2S converter
CP2615 control
Filter A
PCB inductors
PCB coil generator: https://github.com/SK-Electronics-Consulting/kicad-coil-generators
Audio modulation signal input
Raspberry Pi Pico USB audio, I2S links: https://www.reddit.com/r/raspberrypipico/comments/lcmhs5/got_i2s_dac_working_with_pico/ https://shop.pimoroni.com/products/pico-audio-pack?variant=32369490853971 https://github.com/pimoroni/pimoroni-pico/tree/main/examples/pico_audio https://github.com/raspbe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
Misc.
PCB coil inductor calculator: https://coil32.net/online-calculators/pcb-inductor-calculator.html
Impedance matching calculator: https://home.sandiego.edu/~ekim/e194rfs01/jwmatcher/matcher2.html
Discrete components
Hold in reset by default
Filter B
Filter C
R-2R DAC, output filter
USB to I2C converter (CP2615 programming)
R_{out}=1k
TT design control
TT breakout board
FM modulator SPI config
TT design selection
Reserve
Simulation
Raspberry Pi Pico

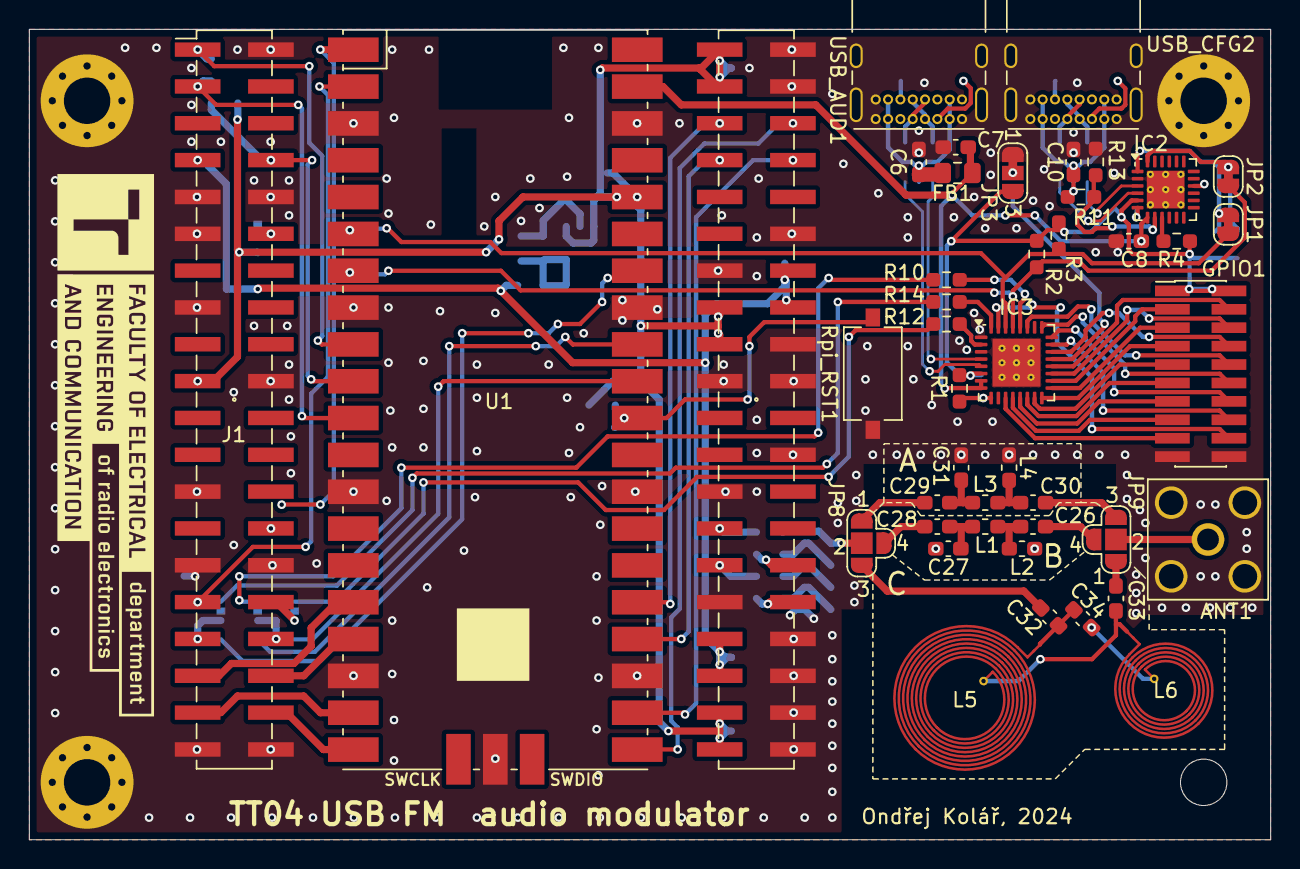
[picture p24: board USB_soundcard_board.kicad_pcb from above]

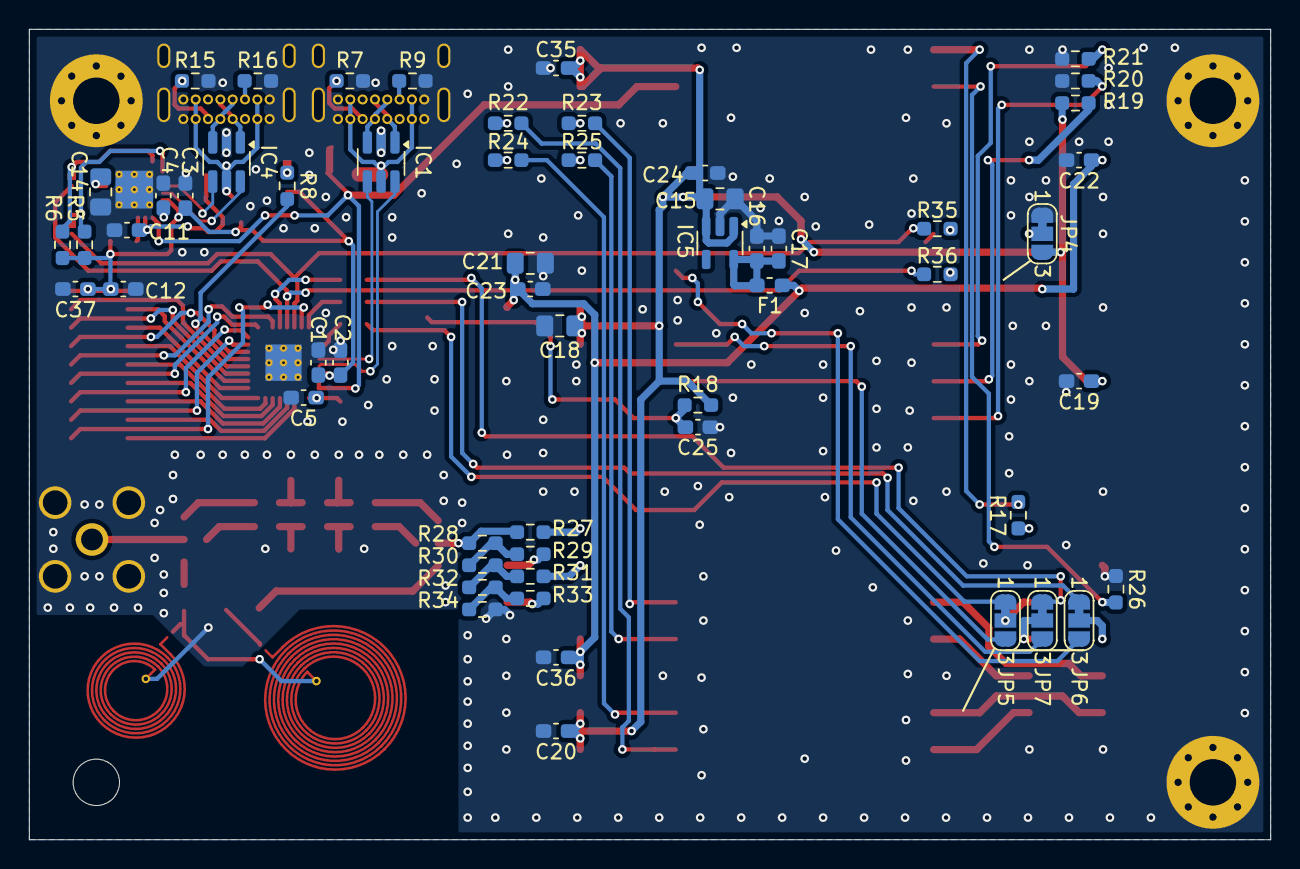
[picture p25: board USB_soundcard_board.kicad_pcb from below]

Board: 2 copper layers, 85.6 x 55.9 mm, 104 parts (57 on the bottom side), 102 nets.
