jankralx/tt04-fm-transmitter/(commit log)

2023-09-04 (src) fixing real type and renaming top design to comply with rules of TT
    [fm_modulator.v, info.yaml, tt_um_fm_transmitter.v]
2023-09-04 (yaml) changing to 1x1 and fixing description
    [info.yaml]
2023-09-04 (documentation) Added design diagram in PNG, fixed frequency in info.yaml
    [info.yaml]
2023-09-07 (src) spi configuration, FM modulator parameters set by signals
2023-09-07 (info yaml, src) fixing emails in info yaml and uio_oe in top module
    [info.yaml, tt_um_fm_transmitter.v]
2023-09-07 (src) fixing same instance name in top module
    [spi_config.v, tt_um_fm_transmitter.v]
2023-09-07 (src) fixing parameters of modulator instance and negedge sensitivity of spi_clk signal
    [fm_modulator.v, spi_config.v, tt_um_fm_transmitter.v]
2023-09-07 (src) fixing two drivers for single nets in top module
    [fm_modulator.v, spi_config.v, tt_um_fm_transmitter.v]
2023-09-07 (src) commenting out spi_config to isolate the error source
    [cdc_slow2fast_bus.v, spi_config.v, tt_um_fm_transmitter.v]
2023-09-07 (src) adding part of spi_config to isolate the error source
    [spi_config.v]
2023-09-07 (src) fixing missing bits in dith_fact assignemnt
    [spi_config.v]
2023-09-07 Added more documentation and schematics.
    [schematic.kicad_sch]
2023-09-07 Fixed schematic sizes.
2023-09-07 (FGPA-USB-Device) adding as submodule
2023-09-08 (src) changing df_inc to df_inc_coef and df_inc_fact for smaller footprint
    [df_inc_calculation.ods]
2023-09-08 (src) fixing selection of multiplexer by df_inc_fact
    [fm_modulator.v]
2023-09-08 (src) trying another implementation of the multiplexer because compilation fails
    [fm_modulator.v]
2023-09-08 (src) fixing width of df_inc_fact and df_inc_coef
    [fm_modulator.v, spi_config.v]
2023-09-08 (src) version tested on FPGA, fixing some mess with signed wires in FM modulator
    [fm_modulator.v, info.yaml, spi_config.v, tt_um_fm_transmitter.v]
2023-09-08 (src) removing negedge register to isolate error source
    [spi_config.v]
2023-09-08 (src) fixing asynchronous reset of spi_miso output register
    [spi_config.v]
2023-09-08 (doc) fixing margins of schematic-DAC.pdf
2023-09-08 (doc) adding missing DAC schematic
    [schematic.kicad_sch]
2023-09-18 (doc) Converted images to PNG.
    [schematic.kicad_sch]
2024-09-09 Added KiCad project of USB soundcard baseboard for the TT04 breakout board.
    [USB_soundcard_board.kicad_pcb, USB_soundcard_board.kicad_sch]
2024-09-18 Added MicroPython code for the Raspberry Pi Pico on the USB board.
2024-09-18 Post-prototype tweaks in USB board schematic
    [USB_soundcard_board.kicad_pcb, USB_soundcard_board.kicad_sch]
2025-01-20 Added filter input impedance trace to the simulation.
    [USB_soundcard_board.kicad_sch]
2025-01-20 (USB_soundcard_board) Added results of filter measurements.
    [FILTER-DISCRETEINDUCTOR-S11.CSV, FILTER-DISCRETEINDUCTOR-S21.CSV, FILTER-PCBINDUCTOR-S11.CSV, FILTER-PCBINDUCTOR-S21.CSV]
2025-02-19 (doc) Added photos of the FM modulator board.
2025-04-11 Updated the USB board Python code
2025-04-11 Added some measurement data
    [10khz.csv, 10mhz.csv, 1mhz.csv, volt_vs_freq.ods]
2025-04-11 Added oscillogram of modulated signal
    [100khzMod10khz.csv]
